EmbeddedSystemClass/max32/README.md

# max32
Hardware and Software replacement for MAX! radiator thermostat
