EmbeddedSystemClass/max32/software/esp32_platformio_idf/readme.md

# Used Libaries
The following libraries were used for the esp32 radiator software  
* esp-mqtt (MQTT Client) - https://github.com/256dpi/esp-mqtt
