EmbeddedSystemClass/max32/CAD/pcb_model/MAX!_PCB.SLDPRT

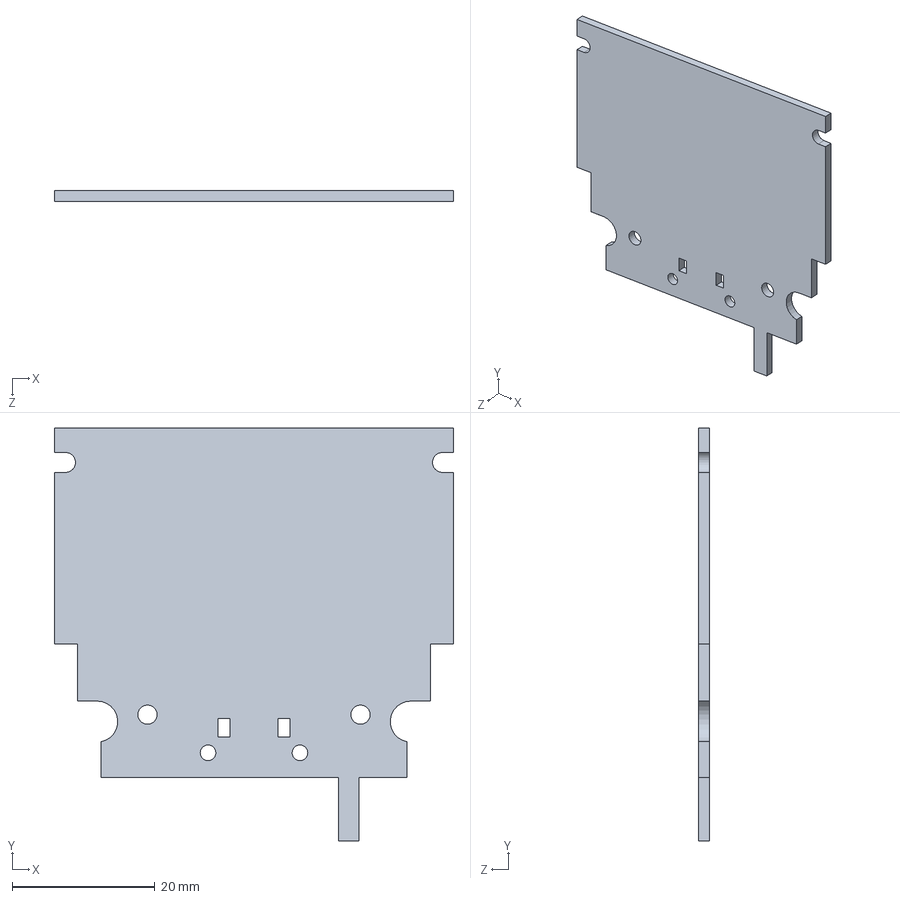
[picture p1: CAD file, 2018-07-01]
CAD/pcb_model/MAX!_PCB.SLDPRT
56.0 x 57.9 x 1.55 mm
