EmbeddedSystemClass/max32/(list of files, cad)

Other CAD files:
CAD/pcb_model/MAX!_PCB.DXF
CAD/pcb_model/MAX!_PCB.SLDDRW
CAD/pcb_model/MAX!_PCB.STL
