EmbeddedSystemClass/max32/MAXboard/MAXboard_V2_schematic.pdf

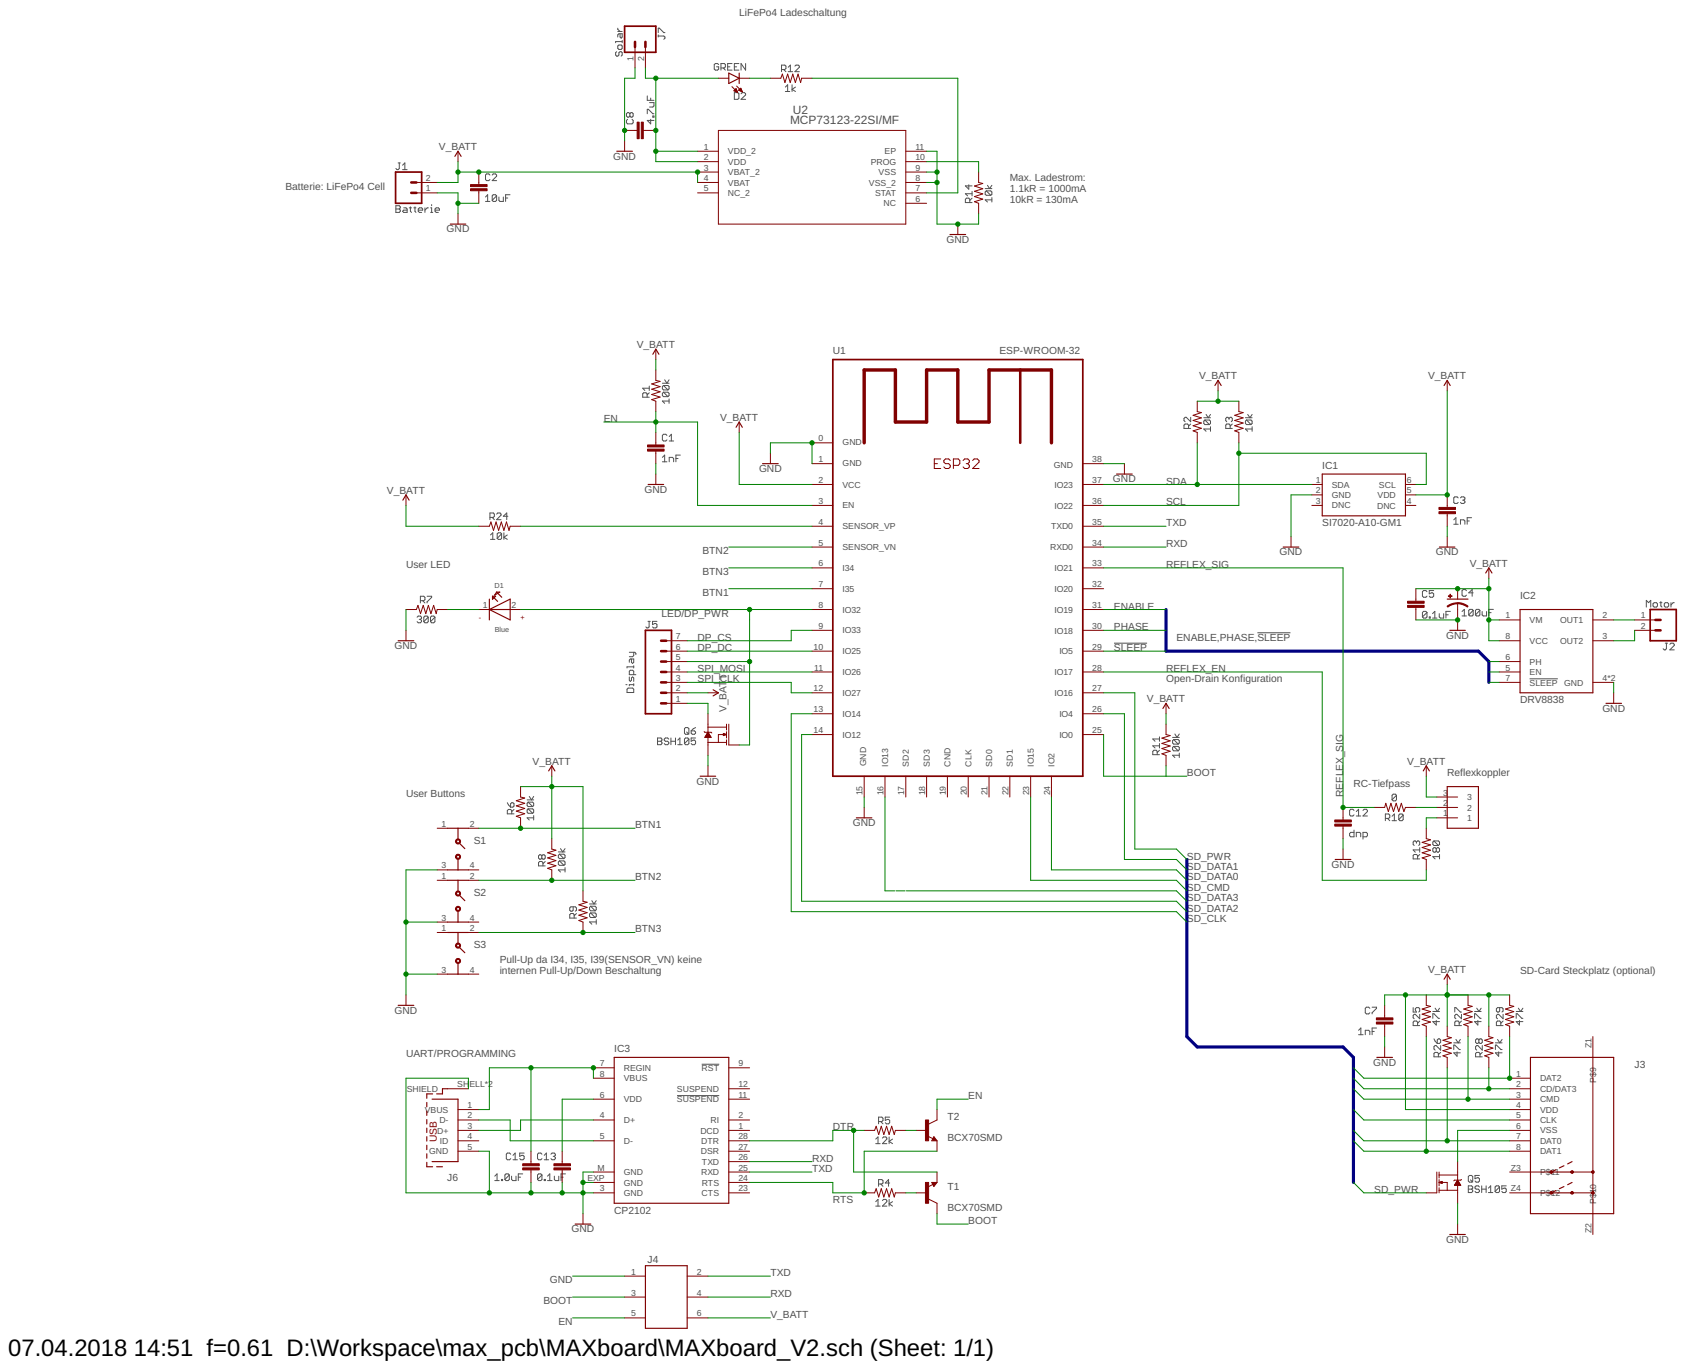
[picture p2: page 1]

Pull-Up da I34, I35, I39(SENSOR_VN) keine
internen Pull-Up/Down Beschaltung

SD-Card Steckplatz (optional)

07.04.2018 14:51 f=0.61 D:\Workspace\max_pcb\MAXboard\MAXboard_V2.sch (Sheet: 1/1)
