EmbeddedSystemClass/max32/MAXboard/MAXboard_V2_pcb.pdf

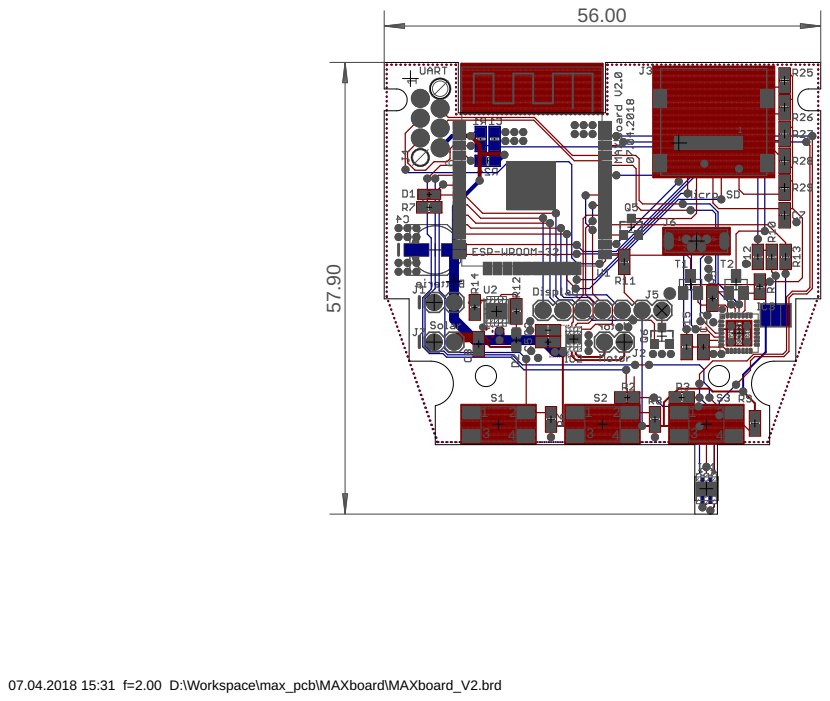
[picture p3: page 1]
