EmbeddedSystemClass/max32/MAXboard/MAXboard_V2.brd

## EAGLE design MAXboard/MAXboard_V2.brd (2018-07-01)

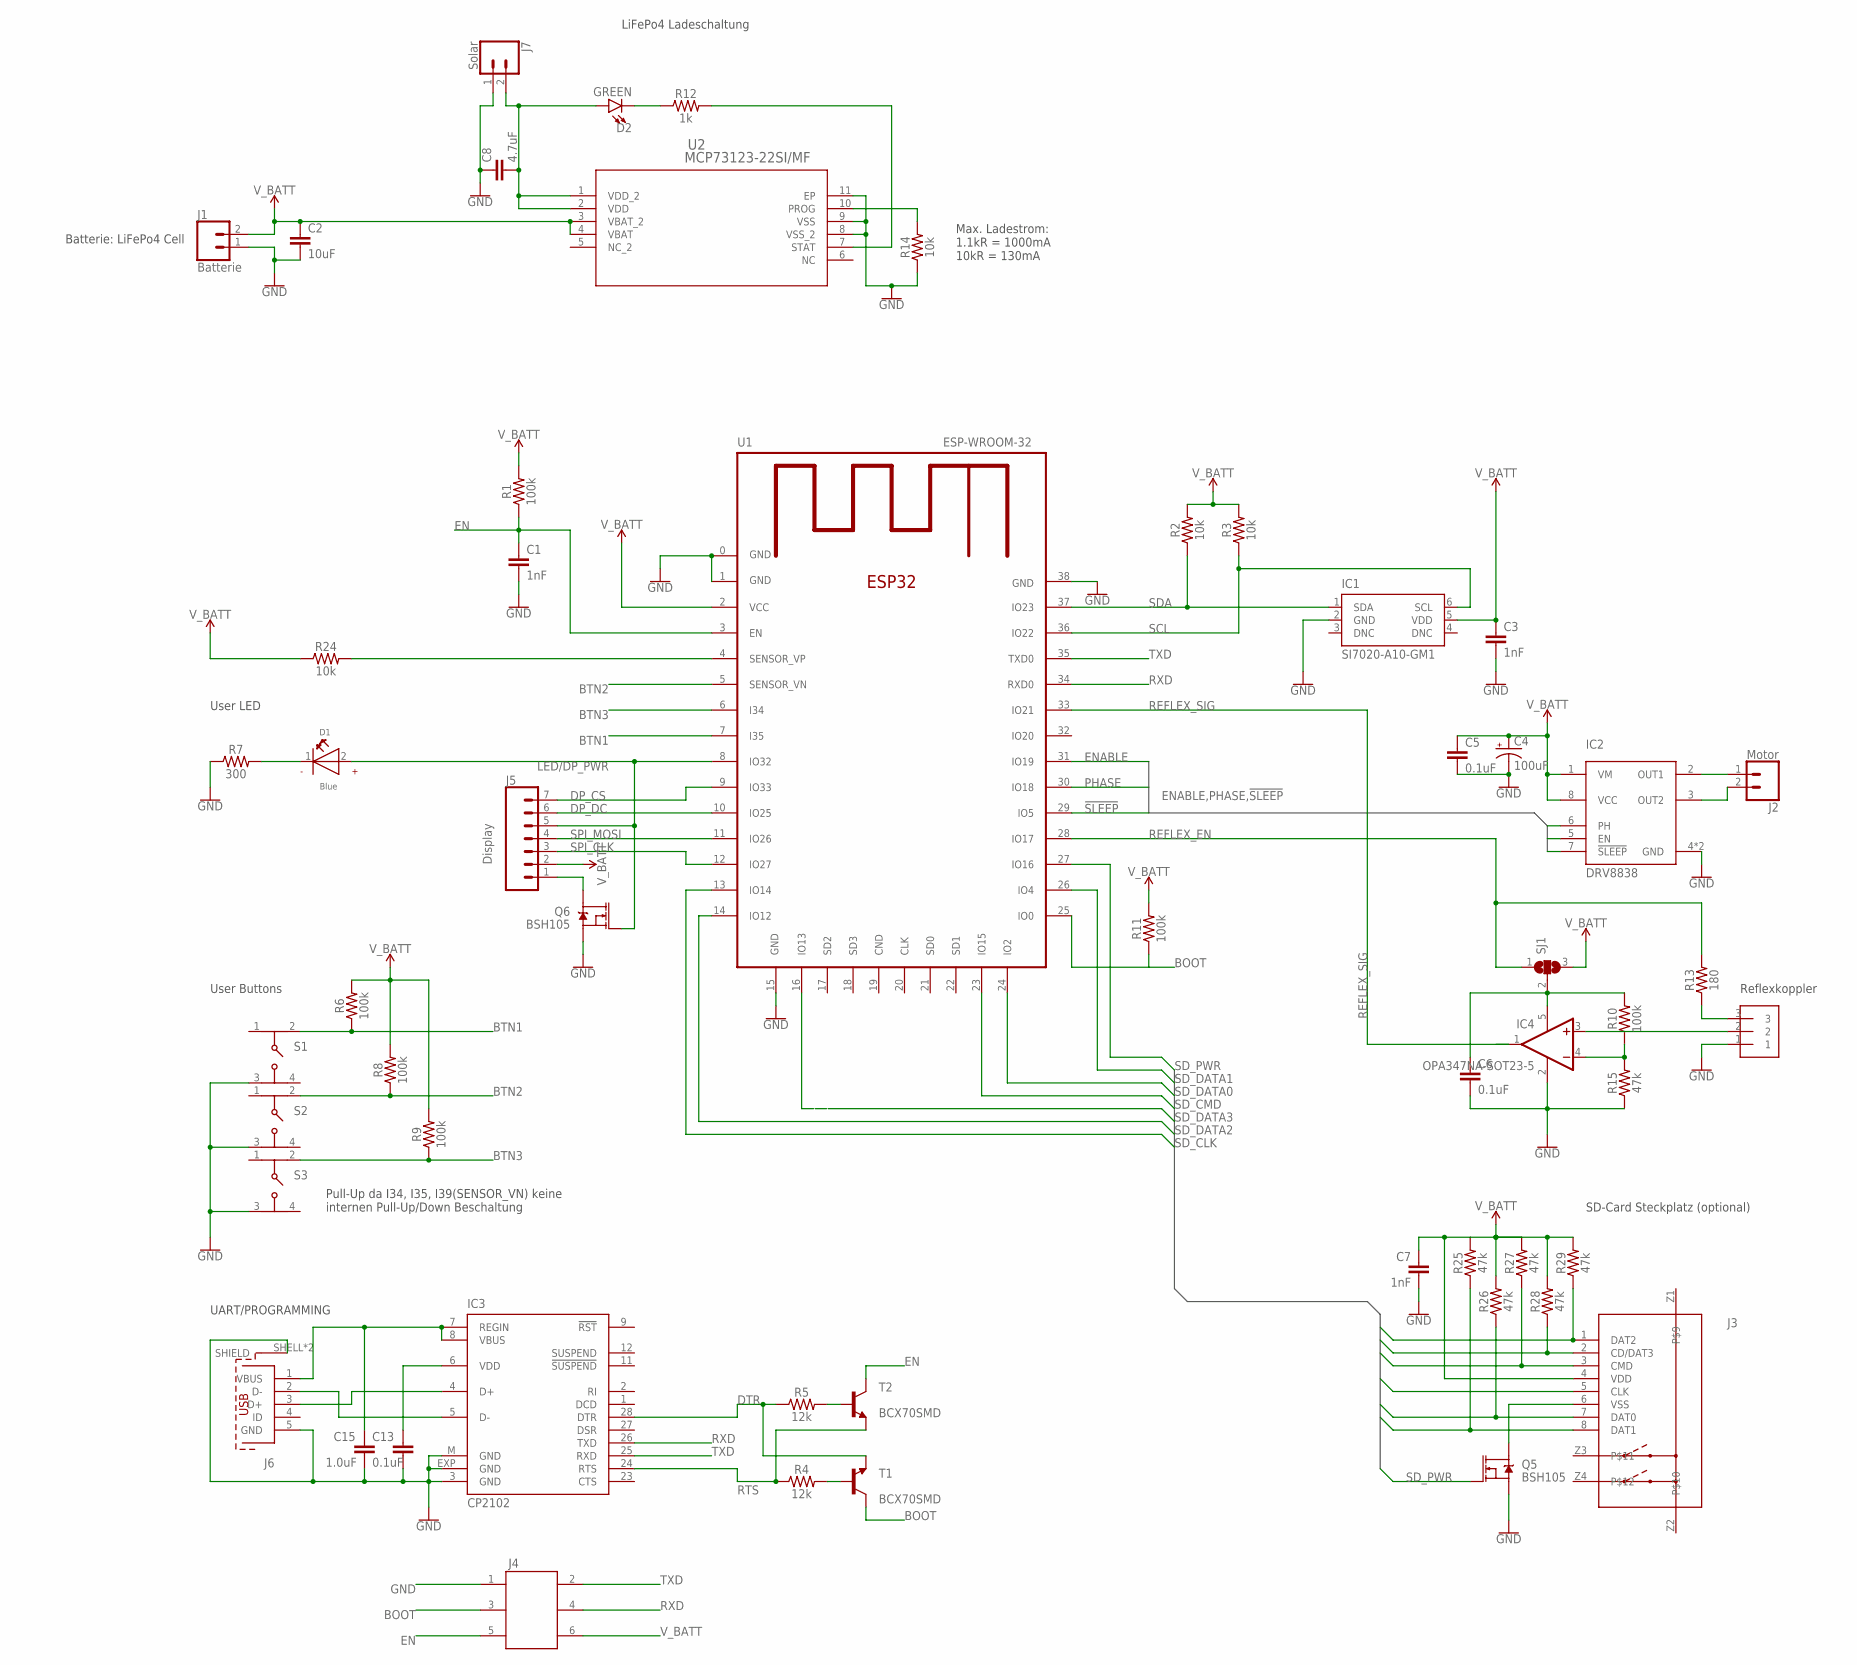
[picture p4: schematic MAXboard_V2.sch]

Parts:
C1, C3, C7: 1nF; 0603
C2: 10uF; 0603
C4: 100uF; PANASONIC_D
C5, C6, C13: 0.1uF; 0603
C8: 4.7uF; 0603
C15: 1.0uF; 0603
D1: Blue; WL-SMCW_0603
D2: GREEN; LED-0603
IC1: SI7020-A10-GM1; DFN6-3X3
IC2: DRV8838; WSON8-2X2
IC3: CP2102; MLP28
IC4: OPA347NA-SOT23-5; SOT23-5
J1: Batterie; 1X02
J2: Motor; 1X02
J3: 693072010801
J4: 490107670612
J5: Display; 1X07
J6: 614105150721
J7: Solar; 1X02
Q5, Q6: BSH105; SOT23-3
R1, R6, R8, R9, R10, R11: 100k; 0603
R2, R3, R14, R24: 10k; 0603
R4, R5: 12k; 0603
R7: 300; 0603
R12: 1k; 0603
R13: 180; 0603
R15, R25, R26, R27, R28, R29: 47k; 0603
S1, S2, S3: 430181038816
SJ1: SJ2W; SJ_2
T1, T2: BCX70SMD; SOT23
U1: ESP-WROOM-32; ESP32MOD
U2: MCP73123-22SI/MF; DFN10_3X3MC
U$1: SMD_3; SMD_3X1.28

Connections:
!SLEEP: IC2.7 (!SLEEP), U1.29 (IO5)
BOOT: J4.3, R11.1, T1.3 (C), U1.25 (IO0)
BTN1: R6.1, S1.2 (3), U1.7 (I35)
BTN2: R8.1, S2.2 (3), U1.5 (SENSOR_VN)
BTN3: R9.1, S3.2 (3), U1.6 (I34)
DP_CS: J5.7, U1.9 (IO33)
DP_DC: J5.6, U1.10 (IO25)
DTR: IC3.28 (DTR), R5.1, T1.2 (E)
EN: C1.1, J4.5, R1.1, T2.3 (C), U1.3 (EN)
ENABLE: IC2.5 (EN), U1.31 (IO19)
GND: C1.2, C2.2, C3.2, C4.-, C5.2, C6.2, C7.2, C8.1, C13.2, C15.2, IC1.2 (GND), IC2.4 (GND), IC2.EXP (GND), IC3.3 (GND), IC3.EXP (GND), IC3.M (GND), IC4.2 (V-), J1.1, J4.1, J6.5 (GND), J6.SHELL (SHIELD), J6.SHELL1 (SHIELD), J7.1, Q5.2 (S), Q6.2 (S), R7.1, R14.1, R15.1, S1.3 (2), S2.3 (2), S3.3 (2), U1.0 (GND), U1.1 (GND), U1.15 (GND), U1.38 (GND), U2.8 (VSS_2), U2.9 (VSS), U2.11 (EP), U$1.1
LED/DP_PWR: D1.2 (+), J5.5, Q6.1 (G), U1.8 (IO32)
unnamed: IC4.3 (+IN), U$1.2
unnamed: IC2.2 (OUT1), J2.1
unnamed: IC2.3 (OUT2), J2.2
unnamed: R24.2, U1.4 (SENSOR_VP)
unnamed: D1.1 (-), R7.2
unnamed: R13.1, U$1.3
unnamed: C15.1, IC3.7 (REGIN), IC3.8 (VBUS), J6.1 (VBUS)
unnamed: IC3.5 (D-), J6.2 (D-)
unnamed: IC3.4 (D+), J6.3 (D+)
unnamed: J5.1, Q6.3 (D)
unnamed: C8.2, D2.A, J7.2, U2.1 (VDD_2), U2.2 (VDD)
unnamed: D2.C, R12.1
unnamed: R12.2, U2.7 (STAT)
unnamed: R14.2, U2.10 (PROG)
unnamed: J3.6 (VSS), Q5.3 (D)
unnamed: IC4.4 (-IN), R10.1, R15.2
unnamed: C6.1, IC4.5 (V+), R10.2, SJ1.2
unnamed: R4.2, T1.1 (B)
unnamed: R5.2, T2.1 (B)
unnamed: C13.1, IC3.6 (VDD)
PHASE: IC2.6 (PH), U1.30 (IO18)
REFLEX_EN: R13.2, SJ1.1, U1.28 (IO17)
REFLEX_SIG: IC4.1 (OUT), U1.33 (IO21)
RTS: IC3.24 (RTS), R4.1, T2.2 (E)
RXD: IC3.26 (TXD), J4.4, U1.34 (RXD0)
SCL: IC1.6 (SCL), R3.1, U1.36 (IO22)
SDA: IC1.1 (SDA), R2.1, U1.37 (IO23)
SD_CLK: J3.5 (CLK), U1.13 (IO14)
SD_CMD: J3.3 (CMD), R27.1, U1.23 (IO15)
SD_DATA0: J3.7 (DAT0), R26.1, U1.24 (IO2)
SD_DATA1: J3.8 (DAT1), R25.1, U1.26 (IO4)
SD_DATA2: J3.1 (DAT2), R29.1, U1.14 (IO12)
SD_DATA3: J3.2 (CD/DAT3), R28.1
SD_PWR: Q5.1 (G), U1.27 (IO16)
SPI_CLK: J5.3, U1.12 (IO27)
SPI_MOSI: J5.4, U1.11 (IO26)
TXD: IC3.25 (RXD), J4.2, U1.35 (TXD0)
V_BATT: C2.1, C3.1, C4.+, C5.1, C7.1, IC1.5 (VDD), IC2.1 (VM), IC2.8 (VCC), J1.2, J3.4 (VDD), J4.6, J5.2, R1.2, R2.2, R3.2, R6.2, R8.2, R9.2, R11.2, R24.1, R25.2, R26.2, R27.2, R28.2, R29.2, SJ1.3, U1.2 (VCC), U2.3 (VBAT_2), U2.4 (VBAT)

Notes on the sheet:
User LED
SD-Card Steckplatz (optional)
Reflexkoppler
User Buttons
UART/PROGRAMMING
Pull-Up da I34, I35, I39(SENSOR_VN) keine internen Pull-Up/Down Beschaltung
Max. Ladestrom: 1.1kR = 1000mA 10kR = 130mA
LiFePo4 Ladeschaltung
Batterie: LiFePo4 Cell

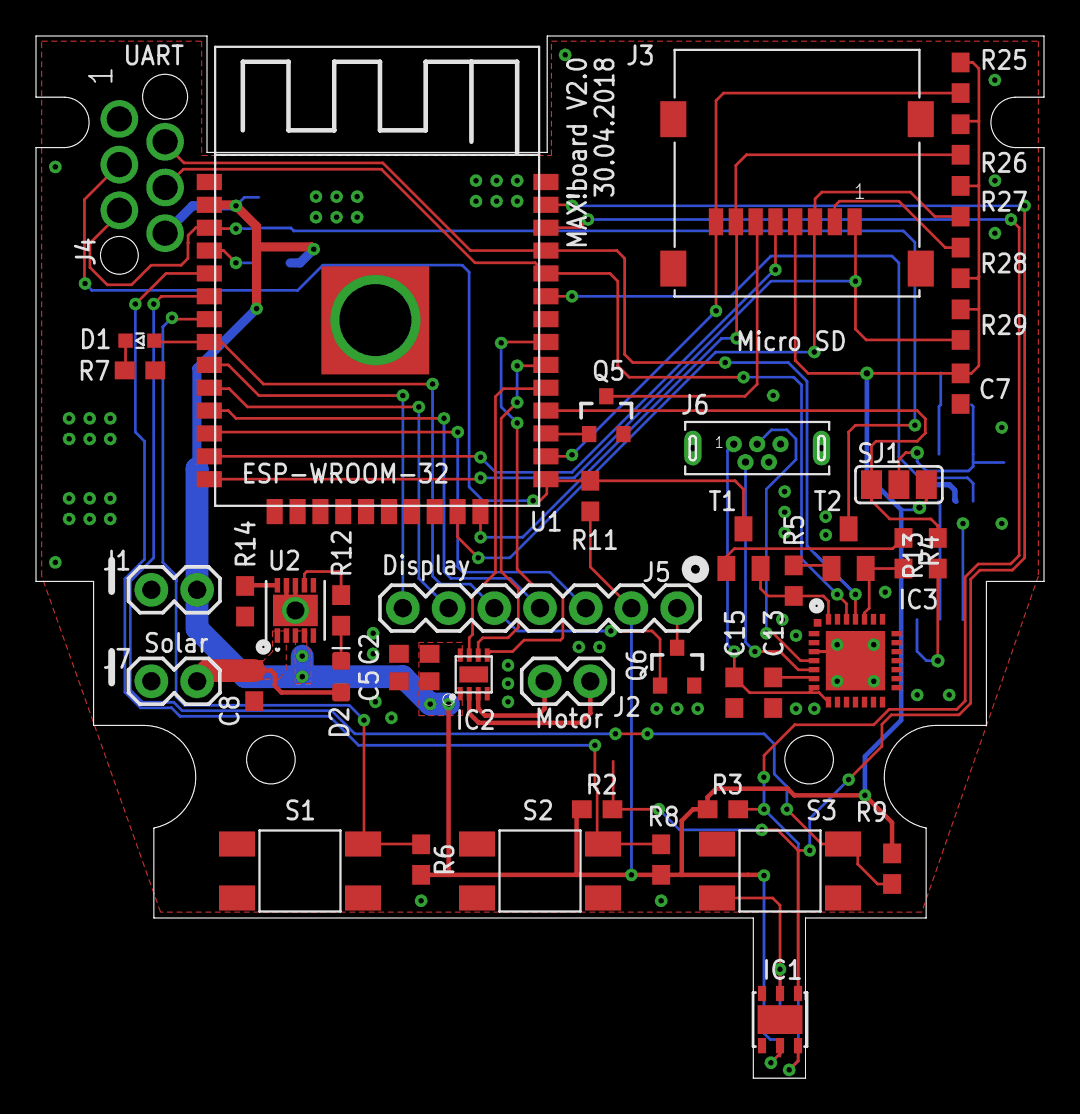
[picture p5: board MAXboard_V2.brd from above]

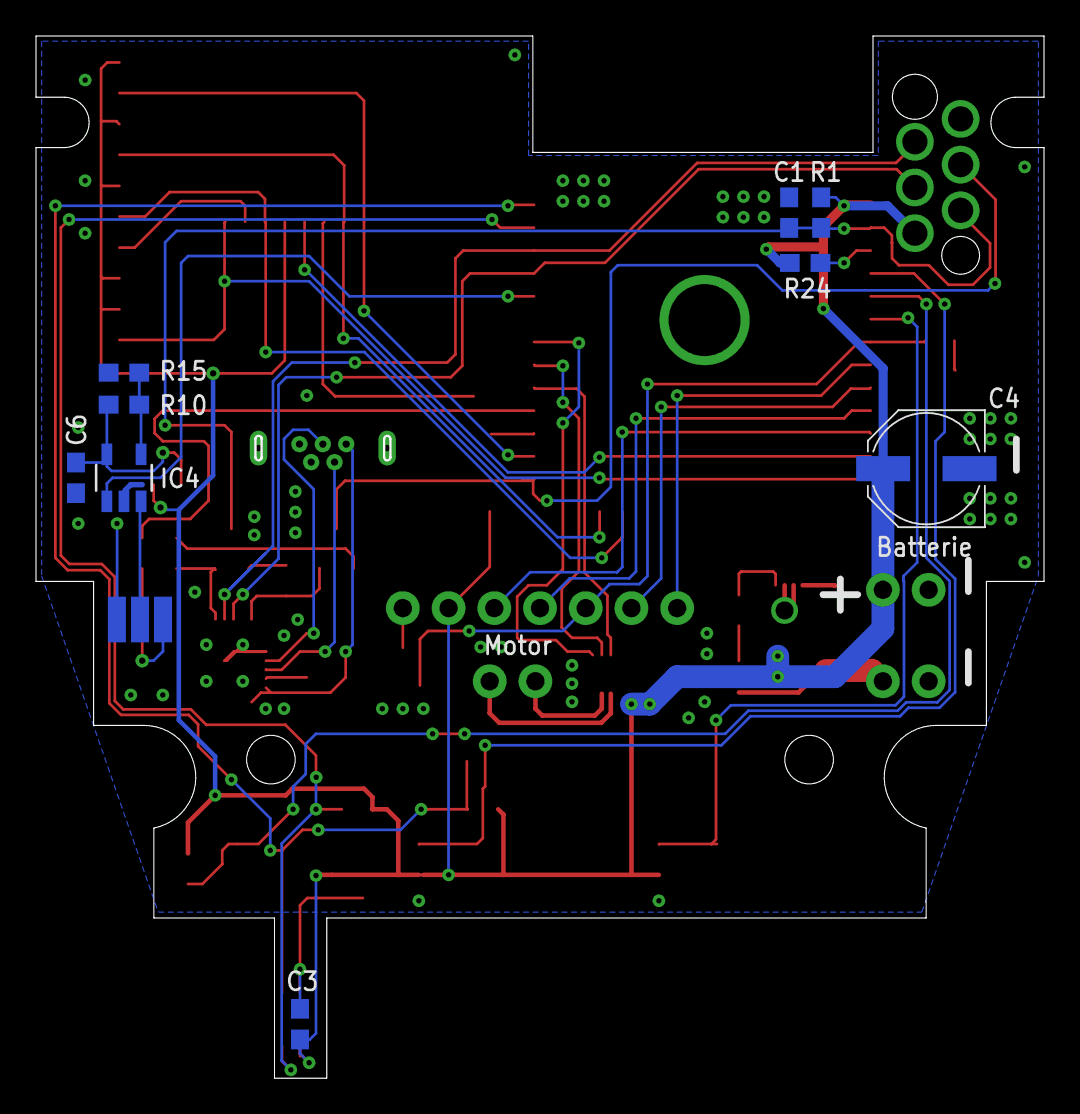
[picture p6: board MAXboard_V2.brd from below]

Board: 2 copper layers, 56.0 x 57.9 mm, 55 parts (10 on the bottom side), 50 nets.
