EmbeddedSystemClass/max32/(notices)

Notices in the files:
parts and their libraries:
si70xx-10: (c) 2014 Samuel Lourenço
SparkFun-DiscreteSemi: Licensing: Creative Commons ShareAlike 4.0 International - https://creativecommons.org/licenses/by-sa/4.0
EAGLE-COLOR_LED-rev17a: Copyright: Würth Elektronik
